pa-i-org/pda.pa-i.org/image/K3100059.jpeg

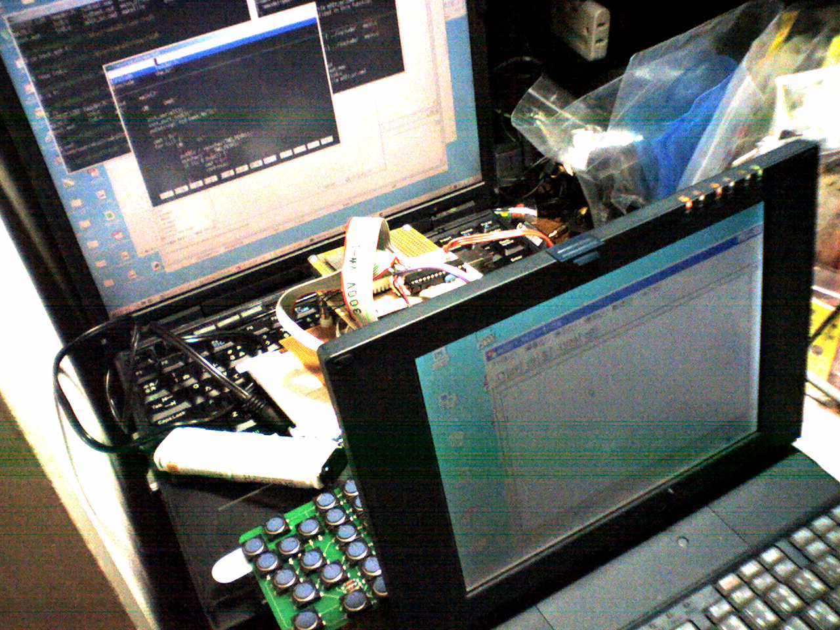
image/K3100059.jpeg
