pa-i-org/pda.pa-i.org/image/K3100061.jpeg

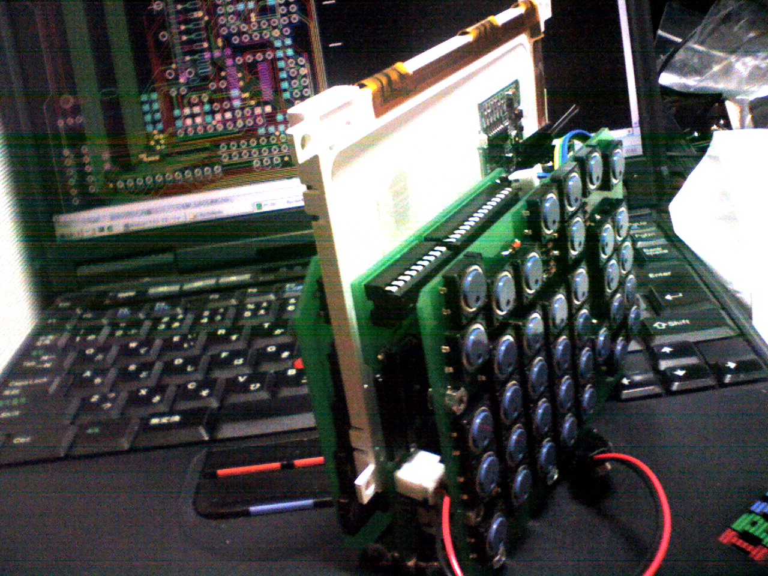
image/K3100061.jpeg
