pa-i-org/pda.pa-i.org/image/K3100067.jpeg

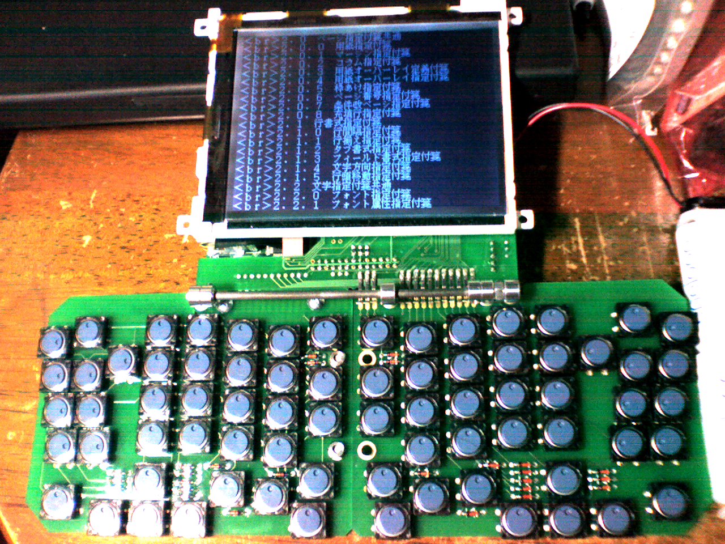
image/K3100067.jpeg
