pa-i-org/pda.pa-i.org/image/K3100068.jpeg

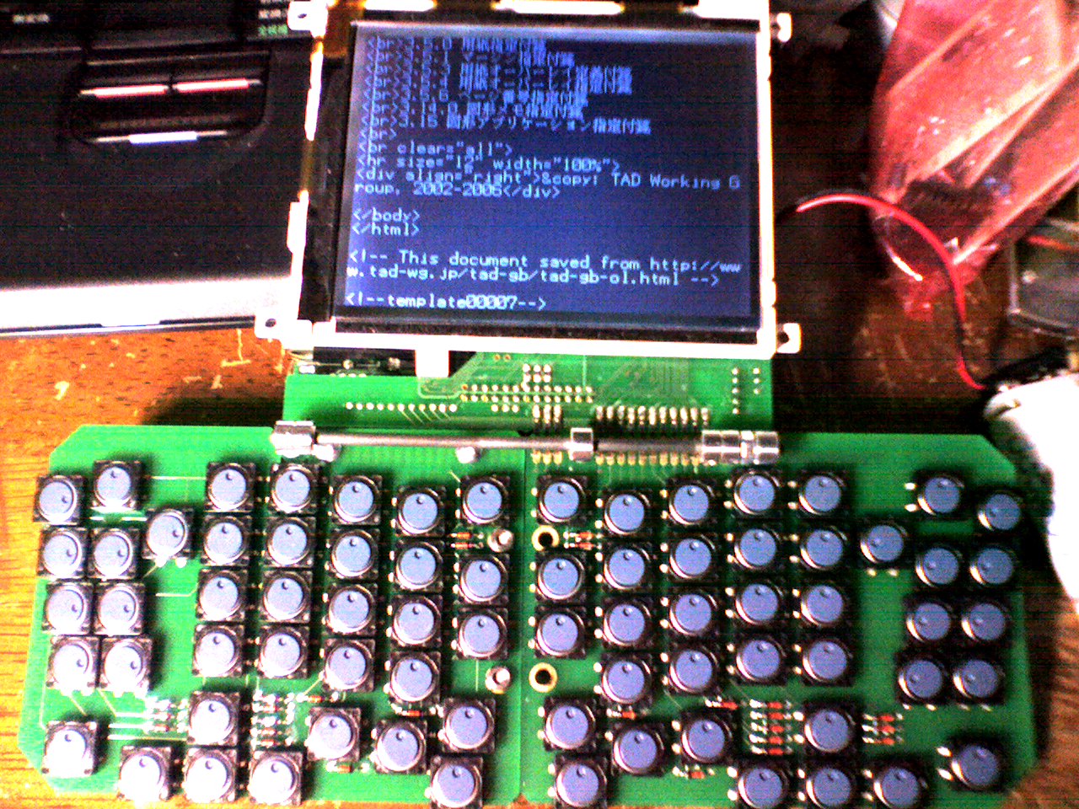
image/K3100068.jpeg
