pa-i-org/pda.pa-i.org/image/K3100070.jpeg

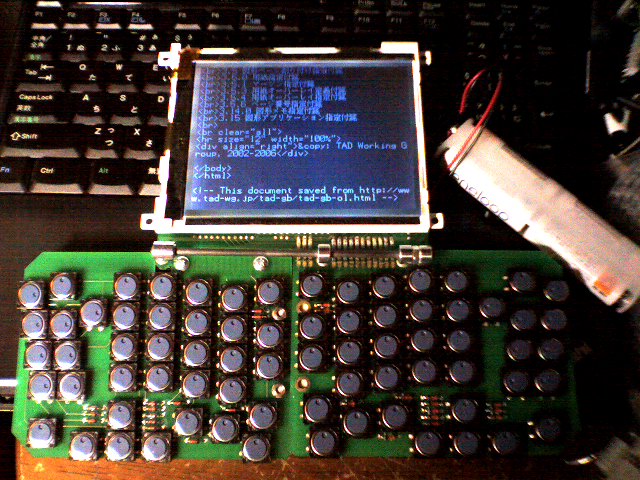
image/K3100070.jpeg
