pa-i-org/pda.pa-i.org/image/K3100072.jpeg

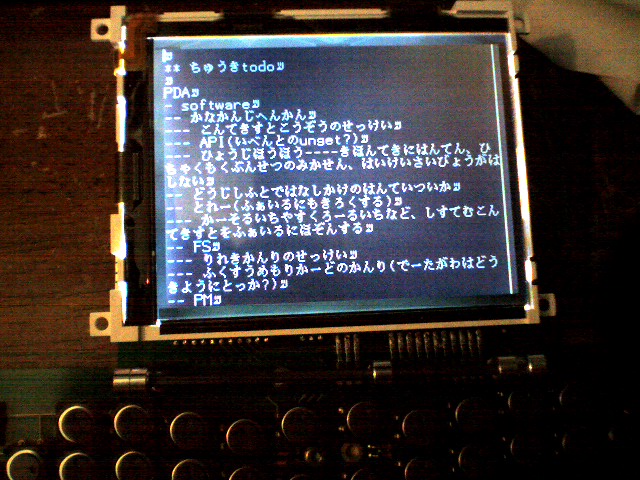
image/K3100072.jpeg
