pa-i-org/pda.pa-i.org/image/K3100171.jpeg

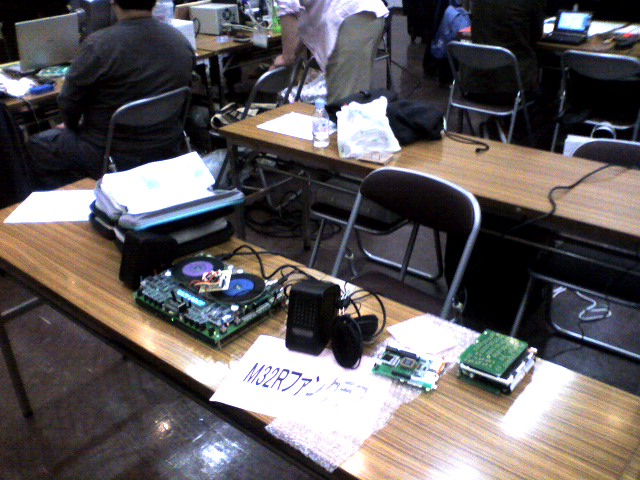
image/K3100171.jpeg
