pa-i-org/pda.pa-i.org/image/K3100172.jpeg

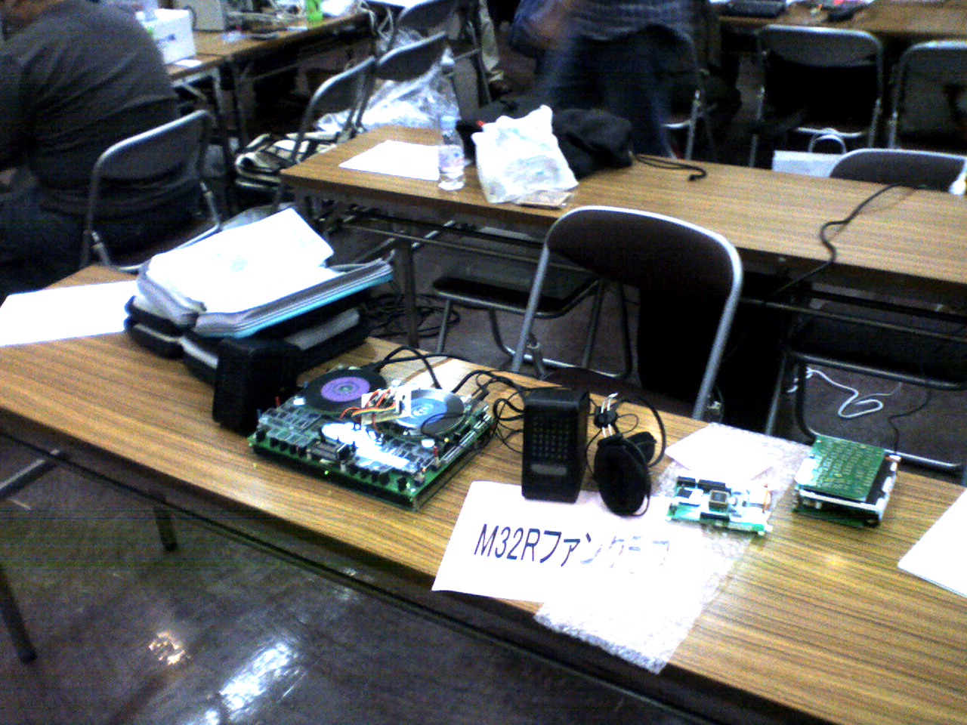
image/K3100172.jpeg
