pa-i-org/pda.pa-i.org/image/K3100252.jpeg

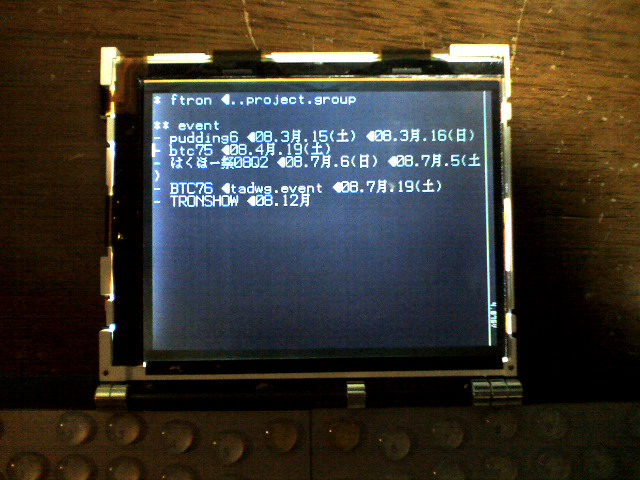
image/K3100252.jpeg
