pa-i-org/pda.pa-i.org/image/K3100269.jpeg

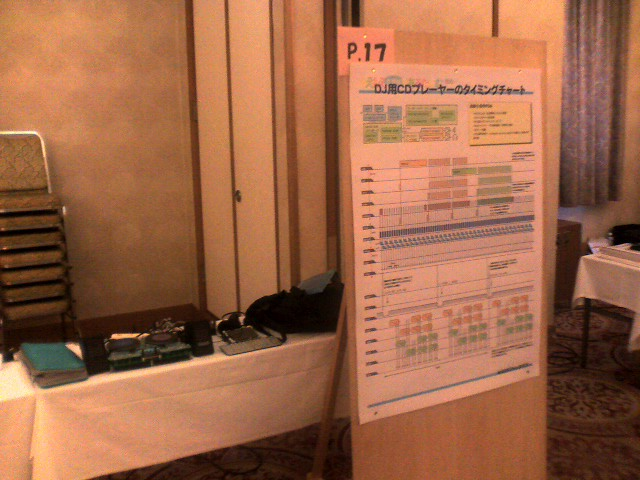
image/K3100269.jpeg
