pa-i-org/pda.pa-i.org/image/K3100411.jpeg

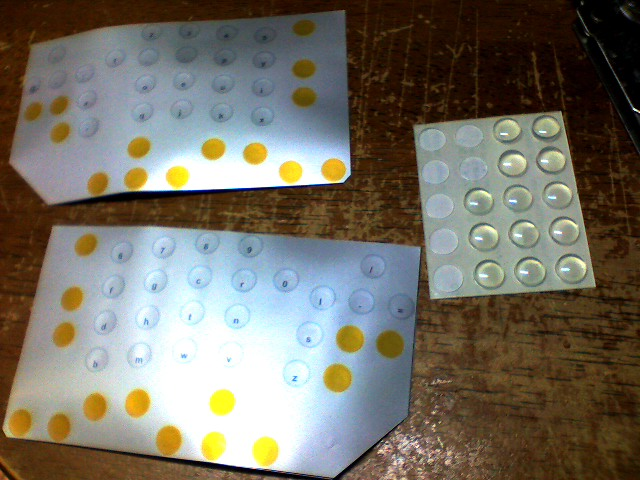
image/K3100411.jpeg
