pa-i-org/pda.pa-i.org/image/pdf-009.jpeg

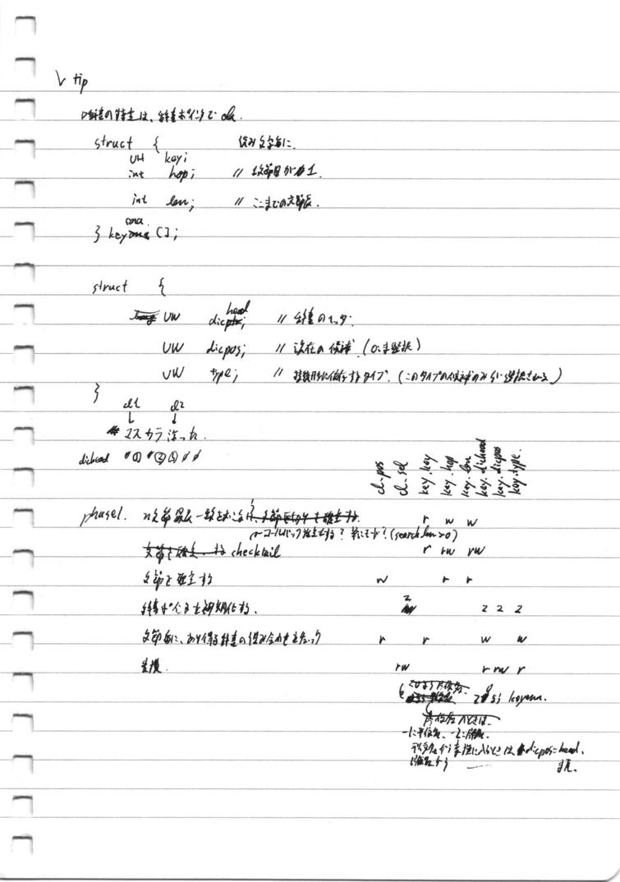
image/pdf-009.jpeg
