pa-i-org/pda.pa-i.org/image/pdf-027.jpeg

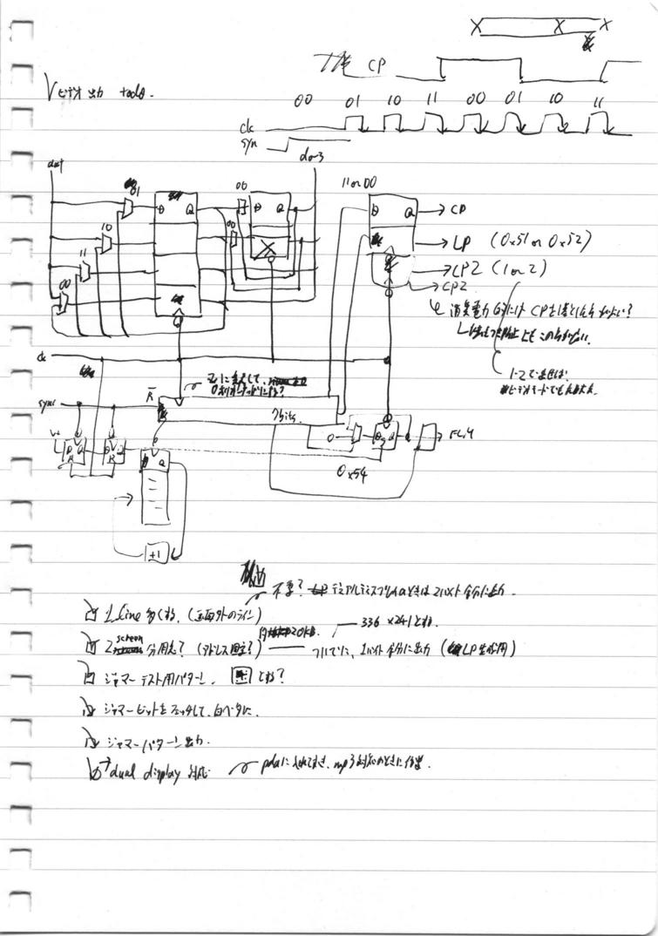
image/pdf-027.jpeg
