pa-i-org/pda.pa-i.org/download/pcb080721.pdf

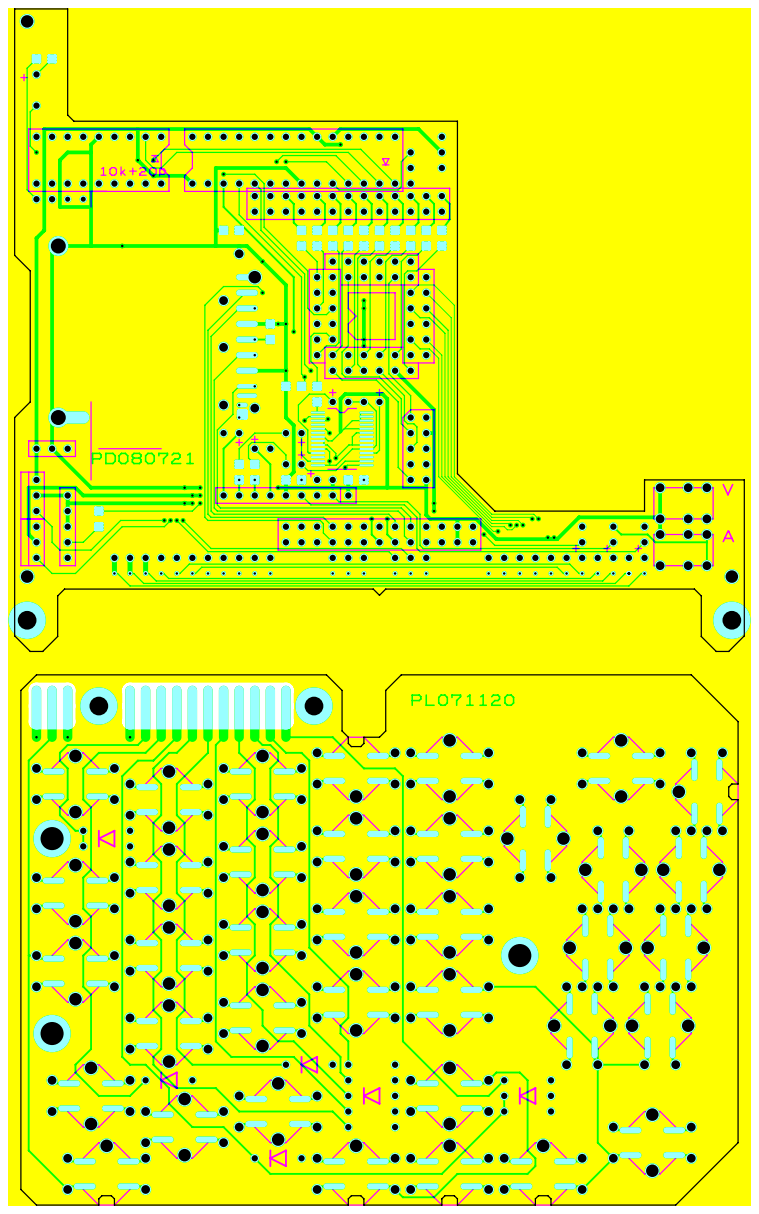
[picture p57: page 1]

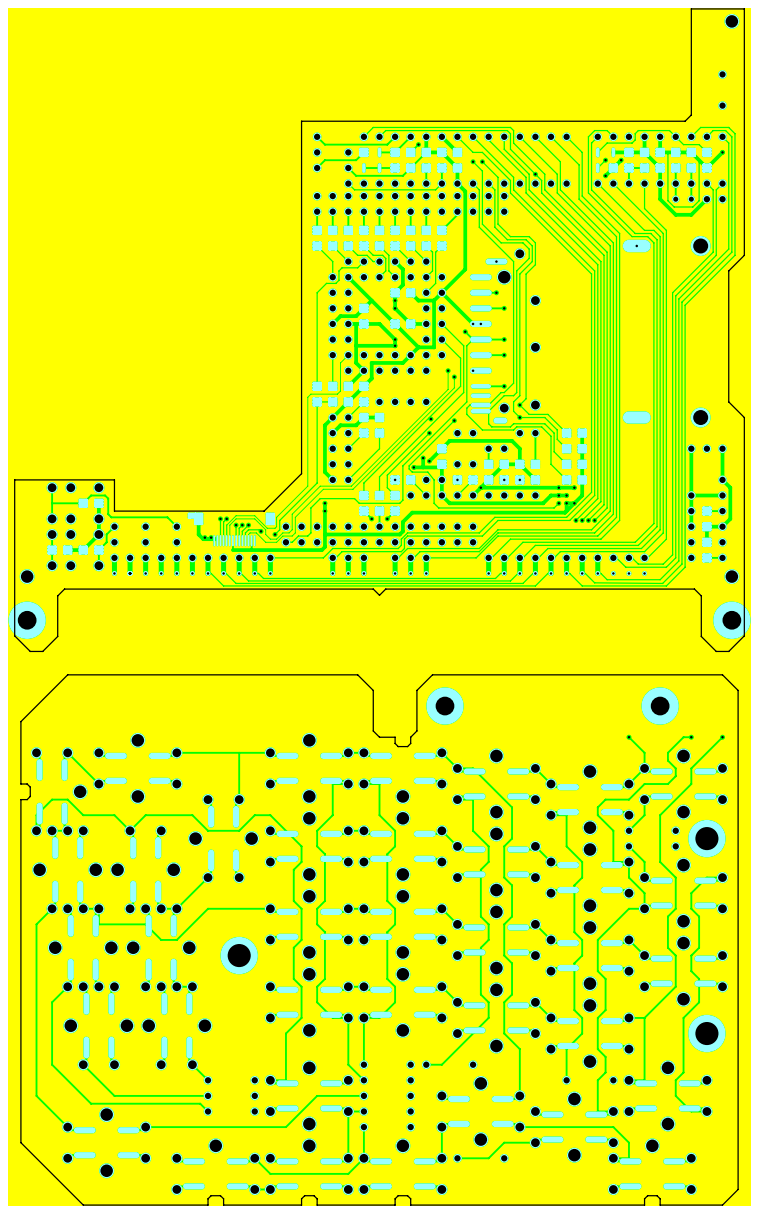
[picture p58: page 2]
