pa-i-org/pda.pa-i.org/(list of files, drawings)

Other design files:
download/pcb080721/pda.pcb
